cwiegert/RouterLift-v5.6-EEPROM/SD Files/SPECIAL.TXT

128 ==> €
129 ==> �
130 ==> ‚
131 ==> ƒ
132 ==> „
133 ==> …
134 ==> †
135 ==> ‡
136 ==> ˆ
137 ==> ‰
138 ==> Š
139 ==> ‹
140 ==> Œ
141 ==> �
142 ==> Ž
143 ==> �
144 ==> �
145 ==> ‘
146 ==> ’
147 ==> “
148 ==> ”
149 ==> •
150 ==> –
151 ==> —
152 ==> ˜
153 ==> ™
154 ==> š
155 ==> ›
156 ==> œ
157 ==> �
158 ==> ž
159 ==> Ÿ
160 ==>  
161 ==> ¡
162 ==> ¢
163 ==> £
164 ==> ¤
165 ==> ¥
166 ==> ¦
167 ==> §
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
