cwiegert/RouterLift-v5.6-EEPROM/Wiegert_Lift_v560_09_20_2021/Wiegert_Lift_v560_09_20_2021.ino

            // Library for the HMI, Nextion 7" touch screen display     
#include <AccelStepper.h>       // Library for Stepper Controller.   Used to talk to the stepper motor
#include "SdFat.h"
#include <EEPROM.h>
#include "RouterLiftGlobVars.h"
#include "RouterLiftNextionObjects.h"


 /*************************************************************************************************************************************
  Wiegert Router Lift

  v.4.4.1_03_15_2020
  3_15_2020
  Cory D. Wiegert

  This is a router lift controller where an arduino mega is wired through a tb6600 connected to a nema23 stepper motor
  using a Nextion 7" intelligent HMI
  
  01/23/2020 -- CDW   important to note, the GetVal functions for all the Nextion objects will only work if utilizing
                      the new base class libraries  NexConfig.h, NexHardware.cpp and NexHardware.h downloaded from
                      https://forum.arduino.cc/index.php?topic=620821.0
                      
                      Through testing - any value over 18000 (at 8 mirosteps) starts overdriving the controller and setting the motors out of phase
                      speeds around 450-650 seem to phase switch the motors as well, and shuddering of the lead screw occurs.

  01/24/2020 -- CDW   IMPORTANT!!!!! Found out the hard way, if we remove buttons or slide things around in the Nextion IDE, make sure to check the object id's with the
                      NEX<object> definition section.   When the create/remove/move around happens in the IDE, it seems the object ID's are modified,
                      thereby causing the listening service on the arduino to mis-match the objects with the call backs.
                    
                      ALSO -- this may be a grounding problem.  If the Nextion is not grounded correctly, there are unexplainable behaviors
                      the same error is flagged when there is a grounding problem

  02/12/2020 -- CDW   change the settings screen, putting the pin and variable configuration into the UI
            v2.7
  02/15/2020 -- CDW   Very good complete version finished.   Will call this version 3.0 and will deploy for burn-in test on teh router table.
            v 3.0      put to the router table on 2/17/2020, have the file for the Memory screen set to tokenize it based on the section
  02/21/2020 -- CDW   Error dialog implemented, fixed error logging to the HMI screen
            v 3.13     Deployed to the router lift on 02/22/2020 at 12/30 PM
  02/23/2020 -- CDW   added versioning, fixed a couple small bugs, redployed to router 
          v. 3.14_02_22_2020
  02/23/2020 -- CDW   modified how the pushcallbacks worked for the up and down buttons on settings and memory
          v. 3.15_02_23_2020
  02/23/2020 -- CDW   modified how all the saves, deletes and write to disk work on Memory screen.   Will add goto 0 button
                      on the memory screen as well.   button will lower router after completing mortise cuts
  02/24/2020 -- CDW   refactored some of the inefficient code, change some fo the callbacks to point to same functions
        v. 4.1_02_24_2020
  02/24/2020 -- CDW   refactored the write to file on the Memory screen.  Now, all lines are read to structure, and rewritten
                      no more losing content, or having strange characters bleed into the file.   No change to the UI in the Nextion
                      IDE
        v 4.1.1_02_24_2020
  02/26/2020 -- CDW   Refactored memory file config.   Allowed for an old file to be opened, and not over write the data in that file
        v. 4.2.1_02_26_2020
  02/29/2020  -- CDW  Refactored errors  to read the strings from a file.  Rewrote function ErrorDialog and all ErrorDialog commands
        v 4.3.1_02_29_2020
  03_07_2020 -- CDW   fixed error on memory screen.   change the check to -currentPosition() because we are storing positions above the tabel as 
                      positive #'s
        v.4.3.2_03_07_2020
  03_08_2020 -- CDW   modified the bits screen, have all the custom bit movement configured in HEIGHTS.cfg, and can configure the bits without
                      having to recompile.   Am using the LoadRouterfromMemory function to set the router off the bits screen
        v.4.4.0_03_08_2020
  03_15_2020 -- CDW   added a position field to the Memory screen so we are notified when the router has stopped moving.   Gives us a flag
                      that we have reached the height set in the depth field.
        v.4.4.1_03_15_2020
  09_19_2020  CDW -- line 1358 moved from 1351.   The top limit switch was not working when router was moving up.   Checking the buffer after 
                      a move insted of before the move.   Up function now exactly the same as the down function
        v. 5.5.0_0_03_2021
  01_03_2021  CDW --   starting the code on the power fence.   Adding ball screw and limit switches, controlling fence with HMI
  02_20_2022  CDW --   modified the setPosition and SaveToMemory functions to account for router position instead of curPos  Needed to fix the settings
                        screen so the router position is set every time instead of getting the fence position if the fence was last button
                        pushed
        v. 5.60_09_20_2021_A
  08_22_2022  CDW --  Modified the section for looking up custom bits from EEPROM.   the bug was EEPROM.read when it should have been EEPROM.get
  10_22_2022  CDW --  Modified readSettingsEEPROM() to use EEPROM.get everywhere.   search date for documented line change
  11_20_2022  CDW --  added the bounceMotorOffLimit function to streamline code and manage the limit switches all in 1 place
  12_07_2022  CDW --  change the limit switches, had to modify loadMemorytoRouter to change the while loops.   Also move to 0 first, then move 
                      to the heights either in the memory or on the presets
  12_11_2022  CDW --  updated bUp and bDown buttons to use moveTo instead of move.
  02_12_2023  CDW --  fixed bug where the automove button was moving very very slowly.   It may have been because there was a read of the stop
                      button in the move loop.   replaced the button.betValue with a nexSerial.read(), similar to what is done on the arrow buttons
  02_22_2023  CDW --  modified the automated move function to bounceMotorOffLimit, instead of putting logic in function
  03_10_2023  CDW --  modified setup to chedk if any motor is pegged against a swtich.   If so, run the bounceMotorOffSwitch() to unpeg it
  09_20_2025  CDW --  reset the environment on the MAC, testing any code readiness to load final working code
                      modified the HMI to pull a useless button, and change background colors.  
                      

*****************************************************************************************************************************************************************************/
      
        /****************************************************************************************
           Decare the AccelStepper object and use the FULL2WIRE as a type of stepper motor.
           connecting to the TB6600, it is a 2 wire control.   

           The pins must be defined and configured here, they can not be part of the Setup - because sRouter is set as a global variable
           it must have the buttons defined, prior to the setup
         *************************************************************************/
//        SdFat   sdCard;                       //  pointer to the SD card reader.   Used in storing config and memory files
        AccelStepper  sRouter (AccelStepper::FULL2WIRE, stepPin, directionPin, HIGH);
        AccelStepper  sFence (AccelStepper:: FULL2WIRE, fenceStepPin, fenceDirPin, HIGH);
        AccelStepper  *sStepper ;
        
        // Declare your Nextion objects - Example (page id = 0, component id = 1, component name = "b0"    Fully qualifying with the screen name
        //  creates ability to use in nexSerial.write commands, without having to go through the libraries)
              
/********************************
  Single function call to turn off power to motor
*********************************/
        
        int turnMotorOff( int bON)
        {
          char  sCommand[44] = {'\0'};
          
          if (bON == UP)                  // Turn the motor controler off
          {
            digitalWrite ( enablePin, HIGH);
            digitalWrite (fenceEnablePin, HIGH);
            //btPower.setValue(UP);
           // btMemOff.setValue(UP);
           // btSetOff.setValue(UP);
            digitalWrite (stepPin, LOW);
            digitalWrite (fenceStepPin, LOW);
            bON =  UP;
          }
          else                           // Turn the motor controller on
          {
            digitalWrite ( enablePin, LOW);
            digitalWrite (fenceEnablePin, LOW);
            //btPower.setValue(DOWN);
            //btMemOff.setValue(DOWN);
            //btSetOff.setValue(DOWN);
            digitalWrite (stepPin, HIGH);
            digitalWrite (fenceStepPin, HIGH);
            bON = DOWN;
          }
          return bON;
        }
        
/******************************************************
  void  getSettingsScreen(char *verString)
      Function to load all the settings from the pins and files.   be very careful with this section
      
01/09/2021 ---->   need to put the settings from the fence ball screw in here.....

09/20/2021 --->   Want to modify this code to use the EEPROM instead of the SD card.   by using EEPROM, the SD shield can be 
                  eliminated, and the top/bottom limits and 0 setting can be stored to EEPROM to reset on startup.
      
********************************************************/
        void   getSettingsScreen( char *verString)
        {
          char    tempWriter[60] = {'\0'};
          float   limTemp;
          int     i = 0;
        
          memset(tempWriter, '\0', sizeof(tempWriter));
          sprintf_P(tempWriter, PSTR("Settings.tUpVal.txt=\"%d\""), TOP_SWITCH);
          nexSerial.write(tempWriter);
          FlushBuffer();
          sprintf_P(tempWriter, PSTR("Settings.tDownVal.txt=\"%d\""), BOTTOM_SWITCH);
          nexSerial.write(tempWriter);
          FlushBuffer();
          sprintf_P(tempWriter, PSTR("Settings.tZeroPin.txt=\"%d\""), REZERO);
          nexSerial.write(tempWriter);
          FlushBuffer();
          sprintf_P(tempWriter, PSTR("Settings.tStepPin.txt=\"%d\""), stepPin);
          nexSerial.write(tempWriter);
          FlushBuffer();
          sprintf_P(tempWriter, PSTR("Settings.tSDPin.txt=\"%d\""), SD_WRITE);
          nexSerial.write(tempWriter);
          FlushBuffer();
          sprintf_P(tempWriter, PSTR("Settings.tEnablePin.txt=\"%d\""), enablePin);
          nexSerial.write(tempWriter);
          FlushBuffer();
          sprintf_P(tempWriter, PSTR("Settings.tDirectionPin.txt=\"%d\""), directionPin);
          nexSerial.write(tempWriter);
          FlushBuffer();
          sprintf_P(tempWriter, PSTR("Settings.tMaxSpeed.txt=\"%ld\""), maxMotorSpeed);
          nexSerial.write(tempWriter);
          FlushBuffer();
          sprintf_P(tempWriter, PSTR("Settings.tWorkSpeed.txt=\"%ld\""), workingMotorSpeed);
          nexSerial.write(tempWriter);
          FlushBuffer();
          sprintf_P(tempWriter, PSTR("Settings.tStepSize.txt=\"%d\""), stepSize);
          nexSerial.write(tempWriter);
          FlushBuffer();
          sprintf_P(tempWriter, PSTR("Settings.tFStep.txt=\"%d\""), fenceStepPin);
          nexSerial.write(tempWriter);
          FlushBuffer();
          sprintf_P(tempWriter, PSTR("Settings.tFEnable.txt=\"%d\""), fenceEnablePin);
          nexSerial.write(tempWriter);
          FlushBuffer();
          sprintf_P(tempWriter, PSTR("Settings.tFDir.txt=\"%d\""), fenceDirPin);
          nexSerial.write(tempWriter);
          FlushBuffer();
          sprintf_P(tempWriter, PSTR("Settings.tBackSW.txt=\"%d\""), BACK_SWITCH);
          nexSerial.write(tempWriter);
          FlushBuffer();
          sprintf_P(tempWriter, PSTR("Settings.tFSW.txt=\"%d\""), FRONT_SWITCH);
          nexSerial.write(tempWriter);
          FlushBuffer();
          sprintf_P(tempWriter, PSTR("Settings.tFZero.txt=\"%d\""), FENCE_ZERO);
          nexSerial.write(tempWriter);
          FlushBuffer();

          sprintf_P(tempWriter, PSTR("Settings.tFileName.txt=\"%s\""), storeFile);
          nexSerial.write(tempWriter);
          FlushBuffer();
          memset (tempWriter, '\0', sizeof(tempWriter));
          tLowLimit.getText(tempWriter, sizeof(tempWriter));
          if (strlen(tempWriter) > 0)
          {
            limTemp = atof(tempWriter) / (distPerStep * 4);
            lowLimit = -limTemp;
          }
          memset (tempWriter, '\0', sizeof(tempWriter));
          tUpLimit.getText(tempWriter, sizeof(tempWriter));
          if (strlen(tempWriter) > 0)
        
          {
            limTemp = atof(tempWriter) / (distPerStep * 4);
            highLimit = -limTemp;
          }
            tVersion.setText (verString);
            FlushBuffer();
        }
      
/*********************************
     int   ErrorDialog (char *outMessage, char *b1Text, char *b2Text, char *yesScreen , char *noScreen)
              this will pop up the error screen, set the message txt in multiline format, set the buttons
              to the text passed in, and if appropriate, navigate to a new place in the app
              The yesScreen and noScreen will navigate to the designated screen when the error dialog is closed.
              b1Text and b2Text will be displayed on the Yes and No buttons
 ***********************************************************************************************/
        
        int   ErrorDialog (int ErrorNum) {
         
          char  msgCommand[300] = {'\0'};
          char  errorString[200] = {'\0'};        // used for the fgets function to read a file line
          char  bYesLbl[24] = {'\0'};
          char  bNoLbl[24] = {'\0'};
          int   serRead[7];
          char  errorTitle[25] = {'\0'};
          char  errorText[200] = {'\0'};
          char  yesScreen[12] = {'\0'};
          char  noScreen[12] = {'\0'};
          char  *token, *elim;
          char  delim[] = {',','\0'};
          char  crCheck[2] = {'^', '\0'};
          char  checker;
          char  errText1[200];
          char  errText2[200];
          char  errText3[200];
          char  errText4[200];
          char  errText5[200];
          int   i, p;
          SdBaseFile   fError;
          if(!fError.open("Error.cfg"))
            {
              return 0;
            }
          fError.rewind();
          checker = '1';
          while (checker != '^')              // read the header
            {
           
              checker = fError.read();
            }

          checker = fError.fgets(errorTitle, sizeof(errorTitle));         //read the carraige return before the errors start
          while ( fError.available())
            {
              memset (errorString, '\0', sizeof(errorString));
              fError.fgets (errorString, sizeof(errorString));
              token =strtok(errorString, delim);

              if (atoi(token) == ErrorNum)
                {
                  for (i=2; i<= 7; i++)
                    {
                      token = strtok(NULL, delim);
                      switch (i)
                        {
                          case 2:
                            strcpy(errorTitle, token);
                            break;
                          case 3:
                            strcpy(errorText, token);
                            break;
                          case 4:
                            strcpy(bYesLbl, token);
                            break;
                          case 5:
                            strcpy(bNoLbl, token);
                            break;
                          case 6:
                            strcpy(yesScreen, token);
                            break;
                          case 7:
                            strcpy(noScreen, token);
                            fError.seekEnd();
                            break;
                        }
                    }
                }
            }
          fError.close();
          nexSerial.write("page Error");
          FlushBuffer();   
          if (strlen(bYesLbl) > 0)
          {
            sprintf_P(msgCommand, PSTR("Error.bYes.txt=\"%s\""), bYesLbl);
            nexSerial.write(msgCommand);
            FlushBuffer();
          }
        
          if (strlen(bNoLbl) > 0)
          {
            sprintf_P(msgCommand, PSTR("Error.bNo.txt=\"%s\""), bNoLbl);
        
            nexSerial.write(msgCommand);
            FlushBuffer();
          }      
         
          sprintf_P(msgCommand, PSTR("Error.tErrorHead.txt=\"%s\""), errorTitle);
          nexSerial.write(msgCommand);
          FlushBuffer();
          memset (msgCommand, '\0', sizeof(msgCommand));
          token = strtok(errorText, crCheck);
          p=0;
          for (i = 0; i<=4; i++)
            {
              if ( token !=NULL)
                {
                  switch (i)
                    {
                      case 0:
                        sprintf_P(errText1, PSTR("%s"),token);
                        break;
                      case 1:
                        strcpy (errText2, token);
                        p++;
                        break;
                      case 2:
                        strcpy (errText3, token);
                        p++;
                        break;
                      case 3:
                        strcpy (errText4, token);
                        p++;
                        break;
                      case 4:
                        strcpy (errText5, token);
                        p++;
                        break;
                    }
                 token = strtok(NULL, crCheck);
                }
              else
                 i=6;
            }
          switch (p)
            {
              case 0:
                sprintf_P(msgCommand, PSTR("Error.tErrorMsg.txt=\"%s\""), errorText);
                break;
              case 1:
                sprintf_P(msgCommand, PSTR("Error.tErrorMsg.txt=\"%s\r\n%s\""), errText1, errText2);
                break;
              case 2:
                sprintf_P(msgCommand, PSTR("Error.tErrorMsg.txt=\"%s\r\n%s\r\n%s\""), errText1, errText2, errText3);
                break;
              case 3:
                sprintf_P(msgCommand, PSTR("Error.tErrorMsg.txt=\"%s\r\n%s\r\n%s\r\n\%s\""), errText1, errText2, errText3, errText4);
                break;
              case 4:
                sprintf_P(msgCommand, PSTR("Error.tErrorMsg.txt=\"%s\r\n%s\r\n%s\r\n\%s\r\n%s\""), errText1, errText2, errText3, errText4, errText5);
                break;
              
            } 
    //      sprintf_P(msgCommand, PSTR("Error.tErrorMsg.txt=\"%s\""), errorText);
          nexSerial.write(msgCommand);
          FlushBuffer();
 
          if (nexSerial.peek() != 101)
            nexSerial.read();
          while (nexSerial.peek() != 101 )
          {
            nexSerial.read();
            delay(100);
          }
          memset(serRead, '\0', sizeof(serRead));
          for (int i = 0; i <= 6; i++)
            serRead[i] = nexSerial.read();
          memset (msgCommand, '\0', sizeof(msgCommand));
          if (serRead[2] == 4)
            sprintf_P(msgCommand, PSTR("page %s"), yesScreen);
          else if (serRead[2] == 5)
            sprintf_P(msgCommand, PSTR("page %s"), noScreen);
          nexSerial.write (msgCommand);
          FlushBuffer();
          return serRead[2];
        
        }


/****************************************************
  int stepsFromDistance( int move_go, int index)

     Returns the  index of the structure that matches with the value from the drop down
     This is typically used after the drop down selection for travel distance
     it will check the move/goto button to figure out if we are moving a set distance
     or setting the height from a fixed position.  If a fixed position, the 0 value of that
     position should be the "table" height
*********************************************/
        
        int stepsFromDistance(int move_go, int index) {
         
          int  counter;
          bool  bContinue =1;
          if(move_go)
            {
              EEPROM.get (4090, eeAddress);   // CDW   modifield 08_22_2022, changed from EEPROM.read to EEPROM.get
              counter = 0;              // called from the automove, looking at heights, 0 based array
            }
          else
            {
              EEPROM.get (4092, eeAddress);    // CDW   modifield 08_22_2022, changed from EEPROM.read to EEPROM.get
              counter = 1;              // called from custom bits screen, looking at custom bits section, 1 based array
            }
      
          do
            {             
               EEPROM.get(eeAddress, preSetLookup);  
               eeAddress += sizeof(preSetLookup);
               counter += 1;
            } while ( bContinue && counter < index + 1);
                        
          return preSetLookup.steps;
        }
/****************************************************        
 *     long   calcSteps (float   inchValue)
 *         returns the number of steps to travel, given the value of inches passed to the function
 ***************************************************/
        long   calcSteps (float inchValue) {
            return inchValue / distPerStep * 4;  // 4 microsteps per step
          
        }

/*************************************************
   void   setPositionField()
            sets the tPosoition field on the home screen.   called after a router move
            03_15_2020 -- added the position field on the Memory screen
   01/03/2021 --- need a fence position field, need to set the position.   Need a variable in the function call to know which position field to change
 *************************************************/
        void setPositionField(bool bMotor) {
          char buffer[16];
          char  sCommand[40];
        
          
          if (bMotor == 1)
            curPosInch = sRouter.currentPosition() * distPerStep / 4;
          else
            curPosInch = sFence.currentPosition() * distPerStep / 4;
          if (curPosInch != 0) 
            {
              memset (buffer, '\0', sizeof(buffer));
              dtostrf(-curPosInch, 3, 4, buffer); 
              dtostrf(-curPosInch, 3, 4, posInch);
            //v. 5.60_09_20_2021_A
              dtostrf(-curPosInch, 3, 4, curRoutPosInch);
            }
          else
            strcpy(buffer, "0.00");
         if (bMotor == 1)
            {
              sprintf_P(sCommand, PSTR("Home.tPosition.txt=\"%s\""), buffer);
              nexSerial.write(sCommand);
              FlushBuffer();
              sprintf_P(sCommand, PSTR("Settings.tSetPosit.txt=\"%s\""), buffer);
              nexSerial.write(sCommand);
              FlushBuffer();
              sprintf_P(sCommand, PSTR("Bits.tBitsPos.txt=\"%s\""), buffer);
              nexSerial.write(sCommand);
              FlushBuffer();
              sprintf_P(sCommand, PSTR("Memory.tMemPosit.txt=\"%s\""), buffer);
              nexSerial.write(sCommand);
              FlushBuffer();
            }
          else
            {
            
              sprintf_P(sCommand, PSTR("Settings.tFencePos.txt=\"%s\""), buffer);
              nexSerial.write(sCommand);
              FlushBuffer();
              sprintf_P(sCommand, PSTR("Memory.tFencePos.txt=\"%s\""), buffer);
              nexSerial.write(sCommand);
              FlushBuffer();
              sprintf_P(sCommand, PSTR("Bits.tFencePos.txt=\"%s\""), buffer);
              nexSerial.write(sCommand);
              FlushBuffer();
              sprintf_P(sCommand, PSTR("Home.tFencePos.txt=\"%s\""), buffer);
              nexSerial.write(sCommand);
              FlushBuffer();
              
            }      
        }
             
/****************************************************************************
 *      void  readSettingsEEPROM()
 *          reads all the pins and motor settings from EEPROM
 *          use EEPROM_WRITER_ROUTER.ino to put all the settings into EEPROM
 *          this will pull them back, and store into the global variables
 * **************************************************************************/
    void readSettingsEEPROM()
      {
          eeAddress = 0;
          EEPROM.get (eeAddress, directionPin);
          eeAddress += sizeof(directionPin);
          EEPROM.get(eeAddress, fenceDirPin);
          eeAddress += sizeof(fenceDirPin);
          EEPROM.get(eeAddress, stepPin);
          eeAddress += sizeof(stepPin);
          EEPROM.get(eeAddress, fenceStepPin);
          eeAddress += sizeof(fenceStepPin);
          EEPROM.get(eeAddress, enablePin);
          eeAddress += sizeof(enablePin);
          EEPROM.get(eeAddress, fenceEnablePin);
          eeAddress += sizeof(fenceEnablePin);
          EEPROM.get(eeAddress, initSpeed);
          eeAddress += sizeof(initSpeed);
          EEPROM.get(eeAddress, stepsPerRevolution);
          eeAddress += sizeof(stepsPerRevolution);
          EEPROM.get(eeAddress, microPerStep);
          eeAddress += sizeof(microPerStep);  
          EEPROM.get(eeAddress, pulseWidthMicros);
          eeAddress += sizeof(pulseWidthMicros);
          EEPROM.get(eeAddress, millisBetweenSteps);
          eeAddress += sizeof (millisBetweenSteps);
          EEPROM.get(eeAddress, TOP_SWITCH);
          eeAddress += sizeof (TOP_SWITCH);
          EEPROM.get(eeAddress, BOTTOM_SWITCH);
          eeAddress += sizeof (BOTTOM_SWITCH);
          EEPROM.get(eeAddress, FRONT_SWITCH);
          eeAddress += sizeof (FRONT_SWITCH);
          EEPROM.get(eeAddress, BACK_SWITCH);
          eeAddress += sizeof (BACK_SWITCH);
          EEPROM.get (eeAddress, REZERO);       //  10_16_2022 CDW --> changed to EEPROM.get to match 
          eeAddress += sizeof(REZERO);
          EEPROM.get(eeAddress, maxAcceleration);
          eeAddress += sizeof(maxAcceleration);
          EEPROM.get (eeAddress, distPerStep);
          eeAddress += sizeof(distPerStep);   
          EEPROM.get(eeAddress, maxMotorSpeed);
          eeAddress += sizeof(maxMotorSpeed);
          EEPROM.get(eeAddress, workingMotorSpeed);
          eeAddress += sizeof(workingMotorSpeed);
          EEPROM.get(eeAddress, ver);
          eeAddress+= sizeof(ver);
  
         if (DEBUG)
           {
              debugLn(F("\r\n========\r\n"));
              debug (F("directionPin ==> "));
              debugLn(byte(directionPin));
              debug (F("fenceDirPin ==> "));
              debugLn(fenceDirPin);
              debug(F("stepPin ==> "));
              debugLn(stepPin);
              debug (F("fenceStepPin ==> "));
              debugLn(fenceStepPin);
              debug (F("enablePin ==> "));
              debugLn(enablePin);
              debug(F("initSpeed ==> "));
              debugLn (initSpeed);       
              debug(F("stepsPerRevolution ==> "));
              debugLn(stepsPerRevolution);
              debug(F("microPerStep ==> "));
              debugLn(microPerStep);       
              debug(F("pulseWidthMicros ==> "));
              debugLn(pulseWidthMicros);
              debug (F("millisBetweenSteps ==> "));
              debugLn(millisBetweenSteps);
              debug (F("TOP_SWITCH ==> "));
              debugLn(TOP_SWITCH);
              debug(F("BOTTOM_SWITCH ==> "));
              debugLn(BOTTOM_SWITCH);
              debug(F("FRONT_SWITCH ==>"));
              debugLn (FRONT_SWITCH);
              debug (F("BACK_SWITCH ==> "));
              debugLn(BACK_SWITCH);
              debug(F("REZERO ==> "));
              debugLn(REZERO);
              debug (F("maxAcceleartion ==> "));
              debugLn(maxAcceleration);
              debug(F("distPerStep ==> "));
              debug(F("maxMotorSpeed == > "));
              debugLn(maxMotorSpeed);
              debug(F("workingMotorSpeed ==> "));
              debugLn(workingMotorSpeed);
              debug(F("version ==> "));
              debugLn(ver);
           }  
      }

/****************************************************************
  void SetSpeedFromSlider (float iSpeed, byte button)

     setSpeedFromSlider will set the  new motor speed in steps per second
     and update the UI wth the new spead values
 *********************************************************/
        
        void setSpeedFromSlider (float iSpeed, byte button) {
          long perCalc;
          char   serCommand[55] = {'\0'};
           if (button == HIGH)
          {
            perCalc = (iSpeed / maxMotorSpeed) * maxMotorSpeed;
          }
          else
          {
            perCalc = (iSpeed / 100) * maxMotorSpeed;
          }
          hMoveSpeed.setValue(perCalc);
          nSetSpeed.setValue(perCalc);
          sprintf_P(serCommand, PSTR("Settings.tWorkSpeed.txt=\"%ld\""), perCalc);
        
          nexSerial.write(serCommand);
          FlushBuffer();
          workingMotorSpeed = perCalc;
        
        }
        
/*************************************************
    void  deleteFromMemory( int memrow)
            Deletes a row from the memory screen
 ******************************/
        void deleteFromMemory (int memrow) {
        
          char zero[21] = {'\0'};
          char steps[20] = {'\0'};
          char label[27] = {'\0'};
        
          snprintf (zero, 14, "tZero%d.txt=\"\"", memrow);
          snprintf(steps, 18, "tMem%dSteps.txt=\"\"", memrow);
          snprintf(label, 26, "tMem%d.txt=\"\"", memrow);
          nexSerial.print(zero);
          FlushBuffer();
          nexSerial.print(steps);
          FlushBuffer();
          nexSerial.print(label);
          FlushBuffer();
        }
        
/*************************************************
    void  saveToMemory( int memrow, double posInch, char curPos)
            adds the current position of the router to 1 of the saved memory spots on Memory Page
 ******************************/
        void saveToMemory (int memrow) {
        
          char zero[30] = {'\0'};
          char steps[30] = {'\0'};
        
        //v. 5.60_09_20_2021_A
          snprintf(zero, 22, "tZero%d.txt=\"%s\"", memrow, posInch);
          snprintf(steps, 24, "tMem%dSteps.txt=\"%ld\"", memrow, sRouter.currentPosition());
          nexSerial.print(zero);
          FlushBuffer();
          nexSerial.print(steps);
          FlushBuffer();
        }
        
/*************************************************
   void  loadMemorytoRouter( int memrow)
           loads the values from memory and sets the router to that position.
******************************/
        void loadMemorytoRouter ( NexText &button, int bHow) {
          char buffer[31];
          float inches;
          long stepsToMove = 0;
          int  buttonNum;
          byte direct;
          uint16_t  characters;

          memset (buffer, '\0', sizeof(buffer));
          characters = button.getText(buffer, sizeof(buffer));
          inches = atof(buffer); 
          stepsToMove = calcSteps (inches); 

/* debugLn("about to call ErrorDialog(200)");
         ErrorDialog(200);
         if (lowLimit == 0)
            buttonNum = ErrorDialog( 200 );  */
         bgotoZeroPopCallback(&bBitsZero);       // 12_7_2022  modified, and move to 0 first, then up to the preset
         sRouter.moveTo(stepsToMove);
         sRouter.setSpeed(-workingMotorSpeed);
         direct = UP;
         bGo = 1;

         while (sRouter.currentPosition() != -sRouter.targetPosition() && bGo && !digitalRead(TOP_SWITCH) && !digitalRead(BOTTOM_SWITCH))  // modified this, as the opposite of the standard values.   Saving above table as + numbers
            {          
              sRouter.runSpeed();


              if (bGo)
                bGo = checkStopButton();
            }
          if (digitalRead(TOP_SWITCH)  || digitalRead(BOTTOM_SWITCH))     // hit a limit switch in the previous loop
            {
              nexSerial.print("vis pStop,1");              // bring up the Stop sign to help remind we have hit a limit switch
              FlushBuffer();
              
              if (digitalRead(TOP_SWITCH))      // 02_22_2023 changed the logic here to call bounceMotorOffLimit
                {
                  bounceMotorOffLimit (TOP_SWITCH, DOWN, &sRouter);
                  //sRouter.moveTo( sRouter.currentPosition() + 600); 
                  //sRouter.setSpeed (workingMotorSpeed);
                }
              else
                {
                  bounceMotorOffLimit (BOTTOM_SWITCH, UP, &sRouter);
                  
                  //sRouter.moveTo(sRouter.currentPosition() - 600); 
                  //sRouter.setSpeed(-workingMotorSpeed);
                }
              //while (sRouter.currentPosition() != sRouter.targetPosition())       // 02_22_2023  commented out because of bounceMotorOffLimit
              //  sRouter.runSpeed();
              bGo = UP;
            }
          nexSerial.print("vis pStop,0");              // bring up the Stop sign to help remind we have hit a limit switch
          FlushBuffer();
          setPositionField(1);    
        }
        
/********************************************************************
 *    void bCustBitPushCallback (void *ptr)
 *        used on the Bits screen to lift the bit to the right height 
 *        likely will call either LoadMemorytoRouter or bAutoCallBack (from the presets)
 *        Needs to calculate steps from thickness (1/2 thickness entered + bit center)
 ************************************************************************/
    void bCustBitPushCallback (void *ptr){
            
      char  thickness[16];
      int   fraction;
      float  inches;
      uint32_t   decimal;
      char   sCommand[80];
      char  newThick[16];
      char   buffer[31];

      memset (thickness, '\0', sizeof(thickness));
      tThickEntry.getText(thickness, sizeof(thickness));
      sw0.getValue(&decimal);
      fraction = decimal;

     if (fraction == 0)      
        {
          inches = (atof(thickness)/2) + preSetLookup.decimal;
          dtostrf(inches, 3, 4, newThick);
          sprintf_P(sCommand, PSTR("t3.txt=\"%s\""),newThick);
          nexSerial.write(sCommand);
          FlushBuffer();
          memset (buffer, '\0', sizeof(buffer));
          fraction =t3.getText(buffer, sizeof(buffer));
        } 
      loadMemorytoRouter (t3, LOW); 
      memset (buffer, '\0', sizeof(buffer));
      sprintf_P(sCommand, PSTR("t1.txt=\"%s\""), preSetLookup.label);
      nexSerial.write(sCommand);
      FlushBuffer();
          
    }
      
/*************************************************
    void  memToFileSD(  NexText &Desc, NexText &Value, NexText &Steps)
            writes index, description, inch value and number of steps to the SD card
 ******************************/
        void memToFileSD ( int index, NexText &Desc, NexText &Value, NexText &Steps, char divider, char section) {
         //void memToFileSD ( int index, char *Desc, char *Value, char *Steps, char divider, char section) {
        
          struct preSets  {
            int     counter;
            char    Name[26];
            char   inches[12];
            char  steps[12];
          }  writeString[8];
        
          char  Name[40] = {'\0'};
          char  writeS[40] = {'\0'};
          char  *token;
          char  checker;
          byte  bFound = 0;
          byte  bGo = DOWN;
          unsigned long   fPos;
          int   element;
 
          for (int counter = 1; counter <= 7; counter++)
            {
              element = 1;
              if (counter != index)   //   looking for the right line to replace in the config
                {
                   EEPROM.get(eeAddress, writeString[counter]);
                   eeAddress += sizeof(writeString);
                   counter++;
                }
               else                   //   Found the line to replace with the new line from the screen
                {
                   writeString[counter].counter = index;
                   Desc.getText(writeString[counter].Name, sizeof(writeString[counter].Name));
                   Value.getText(writeString[counter].inches, sizeof(writeString[counter].inches));
                   Steps.getText(writeString[counter].steps, sizeof(writeString[counter].steps));
                }
            }
          for (int counter=1; counter <=7; counter++)   // rewrite the memory - when writing EEPROM, sprintf
            {
               EEPROM.put(eeAddress, writeString[counter]);
               eeAddress += sizeof(writeString) ;      
            }

        }
/*****************************************************
   int  LoadFromFile ( int StartRow, int NumRows)
          Loads data from config file for the start position up to te number of rows.
          Loads the Memory screen for the rows of specific bookmarked presets
          input:
                  StartRow == which index row to start reading
                  MaxRow == which row to stop reading
                  fileName == which file to use for reading
                  PageNum == which section in the file (going to be used to store different type of settings)
          puts the data into the data fields on the screen
 *****************************************************/
        
        int  LoadFromFile ( int StartRow, int MaxRow, int tokenKey, int Section)  
          {
        
          SdBaseFile    fReader;
          int           element;
          int           counter;
          int           index;
          char          delimeter[2] = {char(tokenKey), '\0'};
          char          *token;
          char          checker;
          uint32_t      filePos;
          char          divider = '^';
        
          struct preSets  {
            char    delimeter[2];
            int     counter;
            char    Name[27];
            char   inches[12];
            char  steps[12];
          }  memory[8];
        
          char        Name[38] = {'\0'};
          char        inches[22] = {'\0'};
          char        steps[25] = {'\0'};
          char        writeS[75] = {'\0'};
        
          if ( !fReader.open(storeFile))
            ErrorDialog (206);   
          index = StartRow;
          fReader.rewind();
          while (writeS[3] != '0' + index && fReader.available()) // read through the header and excluded lines
            fReader.fgets(writeS, sizeof(writeS));
          while (index >= StartRow && index <= MaxRow && fReader.available())
          {
            if (index != StartRow)
            {
              memset (writeS, '\0', sizeof(writeS));
              fReader.fgets(writeS, sizeof(writeS));
            }
            if (writeS[3] != '\0')
              {
                token = strtok(writeS, delimeter);            // tokenize the line and split out the appropriate fields from the string
             
//                strcpy(memory[index].delimeter, char(token)); 
                element = 1;
                while (token != NULL)
                {
                  token = strtok(NULL, delimeter);
                  switch (element)
                  {
                    case 0:
                      element++;
                      break;
                    case 1:
                      memory[index].counter = atoi(token);
                      element++;
                      break;
                    case 2:
                      sprintf_P(memory[index].Name, PSTR("%s"), token);
                      if (memory[index].Name[0] == '\n')
                        memory[index].Name[0] = '\0';
                      element++;
                      break;
                    case 3:
                      sprintf_P(memory[index].inches, PSTR("%s"), token);
                      element++;
                      break;
                    case 4:
                      sprintf_P(memory[index].steps, PSTR("%s"), token);
                      element++;
                      break;
                    case 5:
                      break;
                  }
                }
                index++;
              }
          }
          MaxRow = index;
          for ( index = StartRow; index <= MaxRow; index++)                     //  write the lines to the UI, as many as were round in the file
          {
            snprintf(Name, 37, "tMem%d.txt=\"%s\"", index, memory[index].Name);
            snprintf(inches, 21, "tZero%d.txt=\"%s\"", index, memory[index].inches);
            snprintf(steps, 24, "tMem%dSteps.txt=\"%s\"", index, memory[index].steps);
            nexSerial.write(Name);
            FlushBuffer();
            nexSerial.write(inches);
            FlushBuffer();
            nexSerial.write(steps);
            FlushBuffer();
          }
          fReader.close();
        }
        
/***************************************************
     int   checkStopButton ()
             checks to see if the Off button has been pressed during an automated move of the lift.
             usefull in chagnge bit, move router to limit or Auto button functions
 **********************************************************************/
        byte  checkStopButton ()
        {     
          int incomingByte;
          int   StopButtons[3][2] = {
            {0, 33}, {1, 14}, {2, 56}     //   these are the pages/control #'s for the stop buttons.  if the GUI changes, check here
          };
          int  screen;
          int  button;
        
          bGo = DOWN;
          incomingByte = nexSerial.read();

          while (incomingByte > -1 )
            {
              if (incomingByte == 101)
                {
                  screen = nexSerial.read();
                  button = nexSerial.read();
  
                }
              if ((StopButtons[0][0]== screen && StopButtons[0][1] == button) ||
                  (StopButtons[1][0] == screen && StopButtons[1][1] == button) || 
                  (StopButtons[2][0] == screen && StopButtons[2][1] == button) )
                {
                  bGo = UP;
                  turnMotorOff(UP);
                  return bGo;  
                }
              incomingByte = nexSerial.read();
            }
          return bGo;
        }
        
/*******************************************************
   int moveRouterToLimit(byte bDirection)

       Move to LIMIT is for moving the router until it hits a limit switch
       called by Change Bit  and the ToBottom
          01/24/2020   CDW -- Need to add the bounce function to the limit switch being triggered.    LIkely I will have a "bounce" function so I can call it from all
                              buttons that are free moving.   Whenever a limit switch is hit, we should set the speed to something slow, and bounce back until we enable the
                              limit switch again.   Using a "while LIMITSWITCH==0... move in the opposite direction....."
                              UP/DOWN is motor direction based on lead screw being inverted... UP is dow and DOWN is up
          01/31/2020   CDW -- change the function declaration to return a DOUBLE, it was an int.   Check where function is called to make sure the return is into a DOUBLE
          02/09/2020   CDW -- added the check of the OFF button being pushed.   Will use this functionality to read the reial buffer
                              if the off button is pushed, the motor shoudl stop moving.
  01/03/20201 --- need to rewrite logic to know which motor is moving.   bDirection could be up or down, front or back.   If front to back, need to use sFence instead of sRouter
  11/20/2022  CDW -- modified the bouncing off the limit switches
 * ****************************************/
        
    double moveRouterToLimit (int bDirection, double dSpeedFlag)
        {
          int whichSwitch;
          bGo = DOWN;
          if (bDirection == DOWN)
            whichSwitch = TOP_SWITCH;
          else
            whichSwitch = BOTTOM_SWITCH;
          while (!digitalRead(whichSwitch) && bGo)
          {
            if (bDirection == DOWN)
              {
                curPos = sRouter.currentPosition() - stepSize;
                sRouter.moveTo(curPos);
                if ( dSpeedFlag == -1 )
                  sRouter.setSpeed(-workingMotorSpeed);
                else
                  sRouter.setSpeed (-dSpeedFlag);
              }
            else
              {
                curPos = sRouter.currentPosition() + stepSize;
                sRouter.moveTo(curPos);
                if (dSpeedFlag == -1)
                  sRouter.setSpeed(workingMotorSpeed);
                else
                  sRouter.setSpeed (dSpeedFlag);
              }
              while (sRouter.currentPosition() != sRouter.targetPosition() && !digitalRead(whichSwitch))
                sRouter.runSpeed();
              bGo = checkStopButton();
             // btPower.getValue (&bGo);
              
          }
                  
         if (digitalRead (whichSwitch))
           {
              nexSerial.print("vis pStop,1");              // bring up the Stop sign to help remind we have hit a limit switch
              FlushBuffer();
              bounceMotorOffLimit (whichSwitch, bDirection, &sRouter ); // 11_20_2022 - removed all logic for bouncing.   Call function instead
           }
          nexSerial.print("vis pStop,0");              // bring up the Stop sign to help remind we have hit a limit switch
          FlushBuffer();
          return sRouter.currentPosition();
        }
        
/***********************************************
   void bMoveUpPushCallback(void *ptr)

         Button bMoveUP component push callback function.
         While the button is pressed, the router should move UP and interupt if the limit button is hit
   01/03/2021 --- copy this function for the Fence move back button
******************************************/
      
  void bMoveUpPushCallback(void *ptr) {
          int cBuff = -1;
      
          while (!digitalRead(TOP_SWITCH) && bGo && cBuff == -1)
            {     
              curPos = sRouter.currentPosition() - stepSize;
              sRouter.moveTo(curPos);
              sRouter.setSpeed(-workingMotorSpeed);
              while (sRouter.currentPosition() != sRouter.targetPosition()  && workingMotorSpeed > 0 && !digitalRead (TOP_SWITCH))
                sRouter.runSpeed();             
              cBuff = nexSerial.read();
            
            }
        
          if (digitalRead (TOP_SWITCH))
            {
              nexSerial.print("vis pStop,1");              // bring up the Stop sign to help remind we have hit a limit switch
              FlushBuffer();
              bounceMotorOffLimit (TOP_SWITCH, DOWN, &sRouter ); // 11_20_2022 removed all logic and call function instea
              highLimit = -curPos;
            }
          nexSerial.print("vis pStop,0");              // bring up the Stop sign to help remind we have hit a limit switch
          FlushBuffer();
          setPositionField(1);
        
        }
        
/***************************************************
   void bMoveUpPopCallback(void *ptr)

         Button bMoveUp component pop callback function.
         When the ON button is released, the LED turns on and the state text changes.
************************************/
        void bMoveUpPopCallback(void *ptr) {
          setPositionField(1);     
        }
        
/********************************************************
    void bMoveDownPushCallback (void *ptr)

         Button bMoveUP component push callback function.
        While the button is pressed, the router should move DOWNP and interupt if the limit button is hit

 01/03/2021 -- need to copy this for the Fence move forward button, change sRouter to sFence
 *****************************************************/
        void bMoveDownPushCallback (void *ptr)  {
          int cBuff = -1;
          char buffer[16];          
    
          while (!digitalRead(BOTTOM_SWITCH) && cBuff == -1 && bGo)
          {
            curPos = sRouter.currentPosition() + stepSize;
            sRouter.moveTo(curPos);
            sRouter.setSpeed(workingMotorSpeed);
        
            while (sRouter.currentPosition() != sRouter.targetPosition()  && workingMotorSpeed > 0 && !digitalRead (BOTTOM_SWITCH))
              sRouter.runSpeed();
            cBuff = nexSerial.read();
          }
       
          if (digitalRead(BOTTOM_SWITCH))
            {
              nexSerial.print("vis pStop,1");              // bring up the Stop sign to help remind we have hit a limit switch
              FlushBuffer();
              bounceMotorOffLimit (BOTTOM_SWITCH, UP, &sRouter); // 11_20_2022 removed code, calling function instead
              lowLimit = -curPos;
            }
          
          nexSerial.print("vis pStop,0");              // bring up the Stop sign to help remind we have hit a limit switch
          FlushBuffer();
          setPositionField(1);
     }
        
/****************************************************
   void bMoveDownPopCallback(void *ptr)

        Button bMoveDown component pop callback function.
        When the button is released, turn off the motor controller
*****************************************************/
        void bMoveDownPopCallback(void *ptr) {
        
          setPositionField(1);
        }
             

/***********************************************
   void bForwardPushCallback(void *ptr)

         Button bForward component push callback function.
         While the button is pressed, the router should move UP and interupt if the limit button is hit
   01/08/2021 --- Modify this for moving fence motor, this is only a prototype
******************************************/
      
 void bForwardPushCallback(void *ptr) 
   {
      int cBuff = -1;
      sStepper = &sFence;
    
      while (digitalRead(FRONT_SWITCH) && cBuff == -1 && bGo)
      {     
        curPos = sFence.currentPosition() + stepSize;
        sFence.move(curPos);
        sFence.setSpeed(workingMotorSpeed);
        while (sFence.currentPosition() != curPos)
          sFence.runSpeed();
         cBuff = nexSerial.read();
      }
          
      if (!digitalRead (FRONT_SWITCH) )
        {
          nexSerial.print("vis pStop,1");              // bring up the Stop sign to help remind we have hit a limit switch
          FlushBuffer();
          bounceMotorOffLimit (FRONT_SWITCH, BACK, &sFence);    // 11_20_2022 -- call function instead of all bouncing logic in code
        }
      //highLimit = -curPos;
      nexSerial.print("vis pStop,0");              // bring up the Stop sign to help remind we have hit a limit switch
      FlushBuffer();
      setPositionField(0);
    }
        
/***************************************************
   void bForwardPopCallback(void *ptr)

         Button bMoveUp component pop callback function.
         When the ON button is released, the LED turns on and the state text changes.
  01/08/2021 -- make sure to set the Fence position field on this - needs to be modified
************************************/
        void bForwardPopCallback(void *ptr) {
          setPositionField(0);     
        }

/********************************************************
    void bBackPushCallback (void *ptr)

         Button bBack component push callback function.
        While the button is pressed, the fence will move away from the bit until the button is released 
        or you hit the limit switch

 *****************************************************/
  void bBackPushCallback (void *ptr)  {
          int cBuff = -1;
          char buffer[16];   

          while (digitalRead(BACK_SWITCH) && cBuff == -1 && bGo)
            {
              curPos = sFence.currentPosition() - stepSize;
              sFence.move(curPos);
              sFence.setSpeed( -workingMotorSpeed);
              while (sFence.currentPosition() != curPos  && workingMotorSpeed > 0 && digitalRead(BACK_SWITCH))
                sFence.runSpeed();
            
              cBuff = nexSerial.read();
            }
              
          if (!digitalRead (BACK_SWITCH) )
            {
              nexSerial.print("vis pStop,1");              // bring up the Stop sign to help remind we have hit a limit switch
              FlushBuffer();
              bounceMotorOffLimit (BACK_SWITCH, FORWARD, &sFence);   // 11_20_2022 -- call function instead of all bouncing logic in code
            }
          nexSerial.print("vis pStop,0");              // bring up the Stop sign to help remind we have hit a limit switch
          FlushBuffer();
          setPositionField(0);
        }
        
/****************************************************
   void bBackPopCallback(void *ptr)

        Button bBack component pop callback function.
        When the button is released, set the fence position field
*****************************************************/
        void bBackPopCallback(void *ptr) {
          setPositionField(0);
        }

/************************************************************
   void swHowPopCallback(void *ptr)

         Nothing implemented on this slider button yet
*************************************************************/
        void swHowPopCallback(void *ptr) {      
        }
                
/**************************************************
 * void  swFencePopCallback(void *ptr)
 *      switch swFence on the home screen, will set the HOM_MOTOR byte to know which motor is to be
 *      used by a number of buttons on the home screen   Implmeneted in v. 5.50
 **************************************************/
  void  swFencePopCallback(void *ptr)
    {
        uint32_t   uMotor;
 
        swFence.getValue(&uMotor);
        HOME_MOTOR = uMotor;
    }


/**************************************************
 * void  swWhichPopCallback(void *ptr)
 *      switch swFence on the home screen, will set the HOM_MOTOR byte to know which motor is to be
 *      used by a number of buttons on the home screen   Implmeneted in v. 5.50
 **************************************************/
  void  swWhichPopCallback(void *ptr)
    {
        uint32_t   uMotor;
 
        swWhich.getValue(&uMotor);
        SET_MOTOR = uMotor;
    }

/***********************************************

   void bReZeroPopCallback(void *ptr)

         Button bReZero component push callback function.
         When the button is released, we will want to set a new ZERO reference for the lift.

**************************/
        
        void bReZeroPopCallback(void *ptr) {
        
          if (HOME_MOTOR == 1)
            {
              sRouter.setCurrentPosition(0);
              setPositionField(1);
            }
          else
            {
              sFence.setCurrentPosition (0);
              setPositionField(0);
            }
          
        }
        
/***********************************************
   void bZeroPopCallback(void *ptr)

         Button bZero component push callback function.
         When the button is released, we will want to set a new ZERO reference for the lift.
         Make sure setspeed() is called after move()

 01/13/2021 -- tookk out while loop with run() function, changed to runSpeedToPosition() for router life section.   
**************************/
        
        void bZeroPopCallback(void *ptr) {
        
          char   buffer[20];
          uint32_t   uDirection;
          byte       bDir;
        
          if (SET_MOTOR == 1 )
            {
              sRouter.setCurrentPosition (0);
              while (digitalRead(REZERO) && !digitalRead(TOP_SWITCH) && !digitalRead(BOTTOM_SWITCH) && bGo)   // keep moving the router up until we hit the calibration bar or top limit
                {
                  curPos = sRouter.currentPosition() - stepSize;
                  sRouter.move(curPos);
                  sRouter.setSpeed( -workingMotorSpeed);
                  while (sRouter.currentPosition() != sRouter.targetPosition())
                    sRouter.runSpeed();
                  btPower.getValue(&bGo);
                  //bGo = checkStopButton();
        
                }
              if (!bGo)
                bGo = turnMotorOff(UP);
            
              sRouter.setCurrentPosition(0);
              strcpy(buffer, "tUpLimit.txt=\"0.00\"");
              nexSerial.write(buffer);
              FlushBuffer();
              setPositionField(1); 
            }
          else        // we have chosen to 0 the fence.   Need to check if zeroing from the front to back, or back to front
            {
              swFenceDir.getValue (&uDirection);
              while (digitalRead(FENCE_ZERO) && digitalRead(BACK_SWITCH) && bGo && digitalRead (FRONT_SWITCH))   // keep moving the router up until we hit the calibration bar or top limit
                {             
                  if (uDirection == 0 )
                    curPos = sFence.currentPosition() - stepSize;
                  else
                    curPos = sFence.currentPosition() + stepSize;
                  sFence.move(curPos);
                  if (uDirection == 0 )
                    sFence.setSpeed ( -workingMotorSpeed);
                  else
                    sFence.setSpeed (workingMotorSpeed);
                  sFence.runSpeedToPosition();
                  //bGo = checkStopButton();
                  btPower.getValue(&bGo);
                }
              if (!bGo)
                bGo = turnMotorOff(UP);
            
              sFence.setCurrentPosition(0);
              setPositionField(0); 
            }
        }
        
/******************************************************************
   void bChangeBitPopCallback(void *ptr)

   Button bHomeChageBit component pop callback function.
   Moves the router up at max speed until the limit switch is hit

 01/03/2021 -- move the fence back to the back limit switch.   Need to move the fence out of the way of the router hole insert  
******************************************************************/
        void bChangeBitPopCallback(void *ptr) {
        
          uint32_t  speedFlag;
          char   buffer[12];
        
          bGo = DOWN;
          rMax.getValue(&speedFlag);
          if (speedFlag == 1)
          {
            highLimit = -moveRouterToLimit (DOWN, maxMotorSpeed);
          }
          else
          {
            highLimit = -moveRouterToLimit ( DOWN, -1 );
          }        
          setPositionField(1);        
        }
                        
/*****************************************************
   bToBottomPopCallback(void *ptr)

         Button bToBottom component pop callback function.
         Moves the router up at max speed until the limit switch is hit (Bottom Limit Switch)
***************************************/
        void bToBottomPopCallback(void *ptr) {
        
          uint32_t  speedFlag;
        
          bGo = DOWN;
          rMax.getValue(&speedFlag);
          if (speedFlag == 1)
          {
            lowLimit = -moveRouterToLimit (UP, maxMotorSpeed);
          }
          else
          {
            lowLimit = -moveRouterToLimit ( UP, -1 );
          }
          setPositionField(1);
        }
               
/***********************************************
   void bCalibPopCallback(void *ptr)

         Button bCalib component push callback function.
         WMoves the router to the bottom limit switch, sets the bottom limit field, then moves to top limit switch and sets upper limit field value

  01/03/2021 --- implement the logic for limits for the fence as well.   There should be an upper, lower, front and back limit for the 2 motors  
**************************/
        
        void bCalibPopCallback(void *ptr) {
        
          char    buffer[16];
          float   temp;
          double  curPosInch;
        
          //  mover router to upper limit switch, set the uppor limit variable, then move to bottom Limit switch, store bottom limit
          bGo = DOWN;
          highLimit = -moveRouterToLimit( DOWN, maxMotorSpeed );
          if (bGo)
          {
            memset (buffer, '\0', sizeof(buffer));
            temp = sRouter.currentPosition() * distPerStep / 4;
            dtostrf(-temp, 3, 4, buffer);
            tUpLimit.setText(buffer);
        
            lowLimit = -moveRouterToLimit( UP, maxMotorSpeed );
            if (bGo)
            {
              memset (buffer, '\0', sizeof(buffer));
              curPosInch = sRouter.currentPosition() * distPerStep / 4; // converts the current position to inches from 0
              dtostrf(-curPosInch, 3, 4, buffer);
              tLowLimit.setText(buffer);
            }
          }
          setPositionField(1);
        }
        
/******************************************************
   void bAutoMovePopCallback(void *ptr)

         Button bAutoMove component pop callback function.
         need to check values of direction and move switch to ensure we are moving the right direction
         if switch is set to "goto" we can only go up... it doesn't make sense to goto a negative position
         as the bit will be below the table
         
*********************************************/
        void bAutoMovePopCallback(void *ptr) {
          //  value from swHow   1 is move ||  0 is goto top of table, set bit to height
          //  value from swDirection  0 moves DOWN  || 1 moves UP
        
          float       microSteps = 0;
          uint32_t    bDirection;
          uint32_t    bHow;
          byte        finished = LOW;
          int         StructIndex;
          byte        dir;
          byte        gomove;
          float       calcInch;
          int         selection = 0;
          int         cBuff = -1;       // variable to check whether or not the stop button has been pressed
        
          swHow.getValue(&bHow);
          gomove = bHow;

     /*  CDW  01/23/2022 -- set the 2nd parameter to preSetNum instead of 0.   preSetNum is set when the     
                            cbPreSets is selected.  preSetNum should be the index of the structure to find and convert 
                            to steps, and move the motor  */

          
          StructIndex = stepsFromDistance(HIGH, preSetNum);
          if (gomove == 0 && StructIndex >= 0)
          {
            bgotoZeroPopCallback(&bgotoZero);   // if we are setting an absolute value, go to 0 first, then set the bit height (testing for Fence handled inside)
          }
           
        if (StructIndex >= 0)
          {
            microSteps = (microPerStep * 4) * preSetLookup.steps;
 
            if (HOME_MOTOR == 1)
              curPos = sRouter.currentPosition();
            else
              curPos = sFence.currentPosition();
          }
        if (microSteps)       // only move if there are steps to move, All logic should be wrapped in a mocrosteps function
          {
            if (gomove == LOW)
            {
              swDirection.setValue(LOW);
            }
            swDirection.getValue(&bDirection);
            if (bDirection == UP)
            {
              if (HOME_MOTOR )
                {
                  curPos = sRouter.currentPosition() - microSteps;
                  sRouter.move(curPos);
                  sRouter.setSpeed(-workingMotorSpeed);
                }
              else
                {
                  curPos = sFence.currentPosition() - microSteps;
                  sFence.move(curPos);
                  sFence.setSpeed(-workingMotorSpeed);
                }        
            }
            else
            {
              if (HOME_MOTOR)
                {
                  curPos = sRouter.currentPosition() + microSteps;
                  sRouter.move(curPos);
                  sRouter.setSpeed(workingMotorSpeed);
                }
              else
                {
                  curPos = sFence.currentPosition() + microSteps;
                  sFence.move(curPos);
                  sFence.setSpeed(workingMotorSpeed);
                }
              
            }
            if (HOME_MOTOR)
             {
                while (sRouter.currentPosition() != curPos  && cBuff == -1 && !digitalRead(TOP_SWITCH) && !digitalRead (BOTTOM_SWITCH))
                  {
                    sRouter.runSpeed();
                    cBuff = nexSerial.read();   // 02_12_2023 -- replaced the button read
                  }
        

                if (digitalRead(BOTTOM_SWITCH))
                  {
                    nexSerial.print("vis pStop,1");              // bring up the Stop sign to help remind we have hit a limit switch
                    FlushBuffer();
                    bounceMotorOffLimit (BOTTOM_SWITCH, UP, &sRouter);   // 11_20_2022 -- call function instead of all bouncing logic in code
                    lowLimit = -curPos;
                  }
                else if (digitalRead (TOP_SWITCH))
                  {
                    nexSerial.print("vis pStop,1");              // bring up the Stop sign to help remind we have hit a limit switch
                    FlushBuffer();
                    bounceMotorOffLimit (TOP_SWITCH, DOWN, &sRouter );   // 11_20_2022 -- call function instead of all bouncing logic in code
                    highLimit = -curPos;
                  }                 
                nexSerial.print("vis pStop,0");              // bring up the Stop sign to help remind we have hit a limit switch
                FlushBuffer();
                setPositionField(1);
              }
            else
              {
                 while (sFence.currentPosition() != curPos  && cBuff == -1 && digitalRead(FRONT_SWITCH) && digitalRead(BACK_SWITCH))
                    {
                      sFence.runSpeed();
                      cBuff = nexSerial.read();     // 02_12_2023 -- replaced the button read
                    }
        
                if (!digitalRead (BACK_SWITCH) )
                  {
                    nexSerial.print("vis pStop,1");              // bring up the Stop sign to help remind we have hit a limit switch
                    FlushBuffer();
                    bounceMotorOffLimit (BACK_SWITCH, FORWARD, &sFence);  // 11_20_2022 -- call function instead of all bouncing logic in code
                    lowLimit = -curPos;
                  }
                if (!digitalRead (FRONT_SWITCH) )
                  {
                    nexSerial.print("vis pStop,1");              // bring up the Stop sign to help remind we have hit a limit switch
                    FlushBuffer();
                    bounceMotorOffLimit (FRONT_SWITCH, BACK, &sFence);  // 11_20_2022 -- call function instead of all bouncing logic in code
                    highLimit = curPos;
                  }
      
                nexSerial.print("vis pStop,0");              // bring up the Stop sign to help remind we have hit a limit switch
                FlushBuffer();
                setPositionField(0);
              }
            
          } // end of If microsteps > 0
          setPositionField(1);
          setPositionField(0);
        }
        
/***********************************************
   void bgotoZeroPopCallback(void *ptr)

         Button bgotoZero component push callback function.
        Moves the Router or Fence to the previously set 0 position

  01/03/2021 --- implement check for fence or router movement.   Same logic can be used, but need a flag for whether we are moving the fence       
**************************/
        
        void bgotoZeroPopCallback(void *ptr) {
          String  sHold;
          long    newPos;
          char    buffer[16];
          int     test;
          uint32_t  but;

          vaDelIndex.getValue(&but);
          test = but;
          bGo = DOWN;
          vaFence.getValue (&but);   // need to test variable set by the screen navigation buttons.   When moving off th ehome screen, variable set to Router
          HOME_MOTOR = but;

          if (HOME_MOTOR == 1)
            {
               curPos = sRouter.currentPosition();
               sRouter.move(0);
            }
          else
            {
              curPos = sFence.currentPosition();
              sFence.move(0);
            }          
          if (curPos < 0)
            if (test != 100)
              if (HOME_MOTOR == 1)
                sRouter.setSpeed(workingMotorSpeed);
              else
                sFence.setSpeed (workingMotorSpeed);
            else
              if (HOME_MOTOR == 1)
                sRouter.setSpeed( maxMotorSpeed);
              else
                sFence.setSpeed (maxMotorSpeed);
          else
            if ( test != 100)
              if (HOME_MOTOR == 1)
                sRouter.setSpeed (-workingMotorSpeed);
              else
                sFence.setSpeed (-workingMotorSpeed);
            else
              if (HOME_MOTOR == 1)
                sRouter.setSpeed (-maxMotorSpeed);
              else
                sFence.setSpeed (-maxMotorSpeed);
          
          if (HOME_MOTOR == 1)
            {
              while (sRouter.currentPosition() != 0 && bGo )
                {
                  sRouter.runSpeed();
                  //btPower.getValue(&bGo);
                }
              setPositionField(1);
            }
          else
            {
              while (sFence.currentPosition() != 0 && bGo )
                {
                  sFence.runSpeed();
                  //btPower.getValue(&bGo);
                }
              setPositionField(0);
            }
          
        }
        
/***********************************************
   void bSetDownPushCallback(void *ptr)

         Button bSetDown component push callback function. (on Memory Screen)
         Moves the router down, using the same function as the button on the HOME screen
**************************/
        
        void bSetDownPushCallback(void *ptr) {
        
          bMoveDownPushCallback (&bSetDown);     //call the Callback function for the button from Home page
        }
          
/***********************************************
   void btPowerPopCallback(void *ptr)

         Button btPower component pop callback function.
         if the motor controller enablePin is off, sets it on, and vice versa.
**************************/
        
        void btPowerPopCallback(void *ptr) {
          uint32_t  butVal;
          int       temp;
      
          btPower.getValue(&butVal);
          temp = butVal;        
          if (temp == 0 )
            bGo = turnMotorOff (UP);
          else
            bGo = turnMotorOff( DOWN);
        }
        
/***********************************************
   void btSetOffPopCallback(void *ptr)

         Button btPower component push callback function.
         if the motor controller enablePin is off, sets it on, and vice versa.     
         
**************************/
        
        void btSetOffPopCallback(void *ptr) {
          uint32_t    butVal;
          int         temp;
          int         myVal;

         btSetOff.getValue(&butVal);
          temp = butVal;        
          if (temp == 0 )
          {
            bGo = turnMotorOff (UP);
          }
          else
          {
            bGo = turnMotorOff(DOWN);
          }    
        }
        
/***********************************************
   void btMemOffPopCallback(void *ptr)

         Button btPower component push callback function.
         if the motor controller enablePin is off, sets it on, and vice versa.
         
**************************/
        
        void btMemOffPopCallback(void *ptr) {
          uint32_t  butVal;
          int       temp;
        
          btMemOff.getValue(&butVal);
          temp = butVal;
        
          if (temp == 0)
          {
            bGo = turnMotorOff (UP);
          }
          else
          {
            bGo = turnMotorOff(DOWN);
          }
        }
        
/************************************************************
   void nSpdPopCallback(void *ptr)

         Number field nSpd<index> component pop callback function.
         When the field in the UI is clicked, get the field value and calculate the % of the MaxValue of the slider
         Set the value of the setSpeed field.  That value will be used later to control the speed at which the motor moves up and down
*************************************************************/
        void nSpdPopCallback(void *ptr) {
          uint32_t   scrVal;
          float     temp;
          int       spd;
        
          vaSpeed.getValue( &scrVal);

          temp = scrVal;
          if (temp == 0)
            spd = DOWN;
          else if (temp == 100)
            {
              spd = HIGH;
              temp = maxMotorSpeed;
            }
            
          else
            spd = UP;
          setSpeedFromSlider (temp, spd);
        
        }
        
/*******************************************************************
     void cbPreSetsPopCallBack(void *ptr(

           ComboBox cbPreSets component push callback function.
           A list of preset distances for the router to travel.   This will work with in conjuction with
           swHow and either move the selected amount of distance from a 0'ed spot, or set the bit to the selected
           amount from the surface of the table.   Obviously, we need to know where the surface of the table is

           Need to write serial commands directly for functions, as there are no libraries for this.   assemble the command, then FlushBuffer();
***************************************************************/
        
        void cbPreSetsPopCallBack(void *ptr) {
        
          char           buffer[15] = {'\0'};
        
          memset(buffer, '\0', sizeof(buffer));
          tHoldCombo.getText(buffer, sizeof(buffer));    // gets the text from the preset distance combo box
          memset (preSetTxt, '\0', sizeof(preSetTxt));
          strncpy(preSetTxt,buffer, sizeof(preSetTxt)-1);
          memset(buffer, '\0', sizeof(buffer));
          tHolder.getText(buffer, sizeof(buffer));      // reading the value from the Nextion variable set when the value is selected
          preSetNum = atoi(buffer);
          if (preSetNum > 0)
          {
            setPositionField(1);
          }
        }
        
/************************************************************
   void hMoveSpeedPopCallback(void *ptr)
        Slider hSlider component push callback function
        nSetSpeed is set through tht events in the Nextion IDE.  when the
        PopCallback is fired, we want to set the working motor speed, nothing else
**********************************************************/
        
        void hMoveSpeedPopCallback(void *ptr) {
          uint32_t scrVal;
          float perCalc;
          int slideVal;

          hMoveSpeed.getValue(&scrVal);
          slideVal = scrVal;    // This is the line the overwrites the memory buffer for workingMotorSpeed   conversion of a UINT32_t to a float, cannot be done this way
          setSpeedFromSlider(float(slideVal), DOWN);
        }
        
/***********************************************
    void  bSetMotorPopCallback (void *ptr)
        function to set the motor working speeds from  the settings screen in the app
        
**************************/
        
        void bSetMotorPopCallback (void *ptr) {
          char      motorMax[16] = {'\0'};
          char      workSpeed[16] = {'\0'};
          char      stepStore[8] = {'\0'};
          long      spdVal;
          long      maxMotorSpeed;
        
          memset (motorMax, '\0', sizeof(motorMax));
          memset (workSpeed, '\0', sizeof(workSpeed));
          memset (stepStore, '\0', sizeof(stepStore));
          tMaxSpeed.getText (motorMax, sizeof(motorMax));
          tWorkSpeed.getText (workSpeed, sizeof(workSpeed));
          tStepSize.getText (stepStore, sizeof(stepStore));
        
          maxMotorSpeed = atol(motorMax);
          hMoveSpeed.setMaxval(maxMotorSpeed);
          spdVal = atol(workSpeed);
          if (spdVal > maxMotorSpeed)
            spdVal = maxMotorSpeed;
          hMoveSpeed.setValue(spdVal);
          sRouter.setSpeed (spdVal);                     // set the initial router lift speed to the speed shown on the display
          sFence.setSpeed (spdVal);
          hMoveSpeedPopCallback(&hMoveSpeed);                       // if there is a value for the slider, set the variables in this program
          stepSize = atoi(stepStore);
        
        
        }
        
/***********************************************
    void  bSaveFilePopCallBack (void *ptr)
        function to set the motor working speeds from  the settings screen in the app
    
    09_20_2021 -->   Need to rewrite this section to write to the EEPROM instead of writing 
                     to the file on the SD card
    10_10_2021 -->  haven't re-written this section yet.   Have to figure out memory location and logic
**************************/
        
        void bSaveFilePopCallback (void *ptr) {
        
          char  temp[300] = {'\0'};
          char  newFile[30] = {'\0'};
          SdBaseFile   fSave, fWrite;
          unsigned long   filePos;
          int   action;
          int   numChars = 1;
          char  oldFileName[30] = {'\0'};
          char  checker;
         
          memset (newFile, '\0', sizeof(newFile));
          tFileName.getText(newFile, sizeof(newFile));
          action = ErrorDialog (210);   
          strncpy (oldFileName, storeFile, sizeof(storeFile));
          strncpy(storeFile, newFile, sizeof(storeFile));
          temp[0] = '\0';
          if ( fSave.open (fileName) && fWrite.open (fileName, FILE_WRITE))
            {
              fSave.rewind();
              memset(temp, '\0', sizeof(temp));
              while (temp[0] != char(138)  )                        // read through the header of the file, find the file name section
              {
                filePos = fSave.curPosition();
                numChars = fSave.fgets(temp, sizeof(temp));
              }
              fSave.fgets(temp, sizeof(temp));                      // read the version configuration line
              fWrite.seekSet(filePos);
          
              sprintf_P(newFile, PSTR("%c%s%c\n"), char(138), storeFile, char(138));
              fWrite.write(newFile);
              fWrite.write(temp);                                   // write version back into config file
              numChars = strlen(oldFileName) - strlen(storeFile);    // if the file name is shorter, clean out the remaining letters
              if ( numChars > 0)
              {
                for (int index = 1; index <= numChars; index++)
                {
                  fWrite.write('\0');
                }
              }
              fWrite.sync();
              fSave.close();
              fWrite.close();
            }
          else
            ErrorDialog (212 );  //212
          if (action == 5) 
            {
              //  reuse the file handles to open the old memory config file, read the comments from the top of the file
              //  write them into the new file as a header
              fSave.open(oldFileName);
              fWrite.open(storeFile, FILE_WRITE);
              checker = fSave.read();
              while (checker != '^' && fSave.available())
              {
                fWrite.write(checker);
                checker = fSave.read();
              }
              fWrite.write(checker);
              fWrite.write('\n');
              for (int index=1; index <= 7; index++)
                {
                  sprintf_P(temp, PSTR(",#,%d,,,,\n"),index);
                  fWrite.write(temp);
                }
              fWrite.sync();
              fSave.close();
              fWrite.close();     
            }
          else if (action == 4)
            if (fSave.open (storeFile))
              fSave.close();
            else
              ErrorDialog (214);  
     }
        
/***********************************************
    void bSavePopCallback (void *ptr)
        when the button is pushed on the memory screen, the Nextion will set a screen variable to the button number
        all buttons will call the same PopCallback, and we will get the button number from the variable   
**************************/
        
        void bSavePopCallback (void *ptr) {

          int  index;
          uint32_t save;

          vaIndex.getValue(&save);
          index = save;
          saveToMemory(index);
        }
/***********************************************
    void bDeletePopCallback (void *ptr)
    when the button is pushed on the memory screen, the Nextion will set a screen variable to the button number
        all buttons will call the same PopCallback, and we will get the button number from the variable   
*********************************************/
        
        void bDeletePopCallback (void *ptr) {
          int  index;
          uint32_t save;

          vaDelIndex.getValue(&save);
          index = save;
          deleteFromMemory(index);
        }
/***********************************************
   void btoFilePopCallback (void *ptr)
      function to write values to the SD card.
      when the button is pressed, we set a variable in the Nextion.  That index will tell which button is pressed, 
      and we will construct the object names to pass to the memToFileSD function
**************************/
      
        void btoFilePopCallback (void *ptr) {
          int  index;
          uint32_t save;
          
          vaSDIndex.getValue(&save);
          index = save;

          switch (index)
            {
              case 1:
                memToFileSD ( index, tMem1, tZero1, tMem1Steps, ',', '#');
                break;
              case 2:
                memToFileSD ( index, tMem2, tZero2, tMem2Steps, ',', '#');
                break;
              case 3:
                memToFileSD ( index, tMem3, tZero3, tMem3Steps, ',', '#');
                break;
              case 4:
                memToFileSD ( index, tMem4, tZero4, tMem4Steps, ',', '#');
                break;
              case 5:
                memToFileSD ( index, tMem5, tZero5, tMem5Steps, ',', '#');
                break;
              case 6:
                memToFileSD ( index, tMem6, tZero6, tMem6Steps, ',', '#');
                break;
              case 7:
                memToFileSD ( index, tMem7, tZero7, tMem7Steps, ',', '#');
                break;
            }
        }

   /***********************************************
    void bLoadPopCallback (void *ptr)
        When the button is pressed, a variable is set in the NExtion.   This fuction will retrieve the variable
        and construct the object name to send to loadMemorytoRouter function
**************************/
              
        void bLoadPopCallback (void *ptr)  {
          int  index;
          uint32_t save;
          char  steps[17];

          vaIndex.getValue(&save);
          index = save;
          switch (index)
            {
              case 1:
                loadMemorytoRouter(tZero1, HIGH);
                break;
              case 2:
                loadMemorytoRouter( tZero2, HIGH);
                break;
              case 3:
                loadMemorytoRouter( tZero3, HIGH);
                break;
              case 4:
                loadMemorytoRouter( tZero4, HIGH);
                break;
              case 5:
                loadMemorytoRouter(tZero5, HIGH);
                break;
              case 6:
                loadMemorytoRouter( tZero6, HIGH);
                break;
              case 7:
                loadMemorytoRouter( tZero7,HIGH);
                break;
            }
          }

/*********************************************************
     void  bLoadMemPopCallback (void *ptr)
            Triggers the loading of data from a storage file to the memory screen fields
            will call a function called LoadFromFile()

            169 is the copyright symbol.  Is the token to separate the values in the stream
            216  is the section indicator to show the Memory screen
 *******************************************************/
        void  bLoadMemPopCallback (void *ptr)  {
        
          int  numWritten;
        
          //   numWritten = LoadFromFile(1, 7, 169, 216);
          numWritten = LoadFromFile(1, 7, ',', '#');
        }
/**************************************************
      void bSDCardPopCallback (void *ptr)
         function to restart the SD card controller.   Reissuing the SDCard Begin, resets the card reader after removing SDCard
 ***************************************************/

        void bSDCardPopCallback( void *ptr) {
        
          if (!sdCard.begin(SD_WRITE))
          {
            ErrorDialog (101 );
          }
        
        }

/************************************************
 * void mCustomBitPopCallback (void *ptr)
 *         function to set the heights for the custom bit configurations
 ************************************************/
        void mCustomBitPopCallback (void *ptr)   {

            int  index;
            uint32_t  save;
            char   sCommand[120];
            char   inches[9];

            nBit.getValue(&save);
            index = save;
            stepsFromDistance (LOW, index);
            if (preSetLookup.decimal != 0)
              {
                sprintf_P(sCommand, PSTR("t2.txt=\"%s\""),preSetLookup.label);
                nexSerial.write(sCommand);
                FlushBuffer(); 
                dtostrf(preSetLookup.decimal, 3, 4, inches);       
                t3.setText (inches);
                FlushBuffer();
              }
            else
              {
                sprintf_P(sCommand, PSTR("t2.txt=\"ERROR\""));
                nexSerial.write(sCommand);
                FlushBuffer(); 

              }              
        }
        
/******************************************************************************
   SETUP the main pieces of the program
        
        void setup(void) {
        
          /* You might need to change NexConfig.h file in your ITEADLIB_Arduino_Nextion folder
            Set the baudrate which is for debug and communicate with Nextion screen
            nexInit() = sets the Nextion to Seriel3, and sets baud rate to 9600 unless a value is passed to nexInit()
        
                 01/23/2020  CDW ==>    Modified NexConfig.h, and set the nexSerial to Seriel3.   When implemneting, don't know the exact wriring
                                        config I will use, but in the nexInit prototype , the value for nexSerial needs to be set to the appropriate
                                        port AND!!!!!! the ground from the connector to the nextion must be connected to the ground from the board.  If not,
                                        the listener does not hook up, the Nextion listener  does not function properly, and there is no event queue in
                                        the arduino.
*******************************************************************************/
       void setup (void) 
         {
         
            float perCalc;
            float slideVal;
            uint32_t  scrVal;
            SdBaseFile   fPins;
            int   numChars;
            
            char          pinsString[40] = {'\0'};
       /*     char          motorString[40] = {'\0'};
            char          memFile[30] = {'\0'};
            char          delim[2] = {char(222), '\0'};
            char          delimCheck = char(222);
            char          *token;
            int           index;
            char          checker;*/
            
            nexInit(115200);     //  with enahanced libraries, can pass a baud rate to the Nextion (115200 set on preinitialize of Home)
            //nexBAUD(250000);

            Serial.begin(1000000);
            // Register the pop event callback function of the components
            
            btPower.attachPop(btPowerPopCallback, &btPower);                    //  turn the motor controller on and off by setting the enablePin
            btSetOff.attachPop(btSetOffPopCallback, &btSetOff);                  //  turn the motor controller on and off by setting the enablePin
            btMemOff.attachPop(btMemOffPopCallback, &btMemOff);                  //  turn the motor controller on and off by setting the enablePin     
            bCalib.attachPop(bCalibPopCallback, &bCalib);                       //  Button to move lift to top limit, set top, bottom limit set bottom       
    /*************  home screen 4 buttons Push*/         
            bMoveUp.attachPush(bMoveUpPushCallback, &bMoveUp);                  //  Move Up push - Home Screen
            bForward.attachPush(bForwardPushCallback, &bForward);               //  Move Fence to bit, push - home screen
            bBack.attachPush(bBackPushCallback,&bBack);                         //  Move Fence away from bit, push -- home screen
            bMoveDown.attachPush(bMoveDownPushCallback, &bMoveDown);            //  Move Down press - Home Screen

            /*********** home screen 4 buttons POP ****/
            bForward.attachPop(bForwardPopCallback, &bForward);                 //  Move fence to bit release - home screen
            bBack.attachPop(bBackPopCallback, &bBack);                          //  Move Fence away from bit, release -- home screen
            bMoveDown.attachPop(bMoveDownPopCallback, &bMoveDown);              //  Move Down release - Home Screen
            bMoveUp.attachPop(bMoveUpPopCallback, &bMoveUp);                    //  Move Up release - Home Screen      
    /*********** Settings screen 4 buttons PUSH****/         
            bUp.attachPush(bMoveUpPushCallback, &bUp);                          //  Move Up push - Settings Screen
            bDown.attachPush(bMoveDownPushCallback, &bDown);                    //  Move Down press - Settings Screen         
            bSetBack.attachPush(bBackPushCallback, &bSetBack);                    //  Move Back push - Settings Screen         
            bSetForward.attachPush(bForwardPushCallback, &bSetForward);          //  Move Forward press  (Settings)     
    /************ Settings Screen 4 buttons POP ******/        
            bSetForward.attachPop(bForwardPopCallback, &bSetForward);           //  Move Forward release - Settings Screen
            bSetBack.attachPop(bBackPopCallback, &bSetBack);                   //  Move Back release - Settings Screen
            bDown.attachPop (bMoveDownPopCallback, &bDown);
            bUp.attachPop (bMoveUpPopCallback, &bUp);
    /************Memory Screen   4 buttons Push ******/         
            bMemForward.attachPush(bForwardPushCallback, &bMemForward);         //  Move Forward press  (Memory Memory)                        
            bSetUp.attachPush(bMoveUpPushCallback, &bSetUp);                    //  Move Up push  (Memory Screen)
            bMemBack.attachPush(bBackPushCallback, &bMemBack);                  //  Move Up push  (Memory Screen)          
            bSetDown.attachPush(bMoveDownPushCallback, &bSetDown);              //  Move Down press  (Memory Screen)
    /**********Memory Screen 4 buttons POP ******/
            bMemForward.attachPop(bForwardPopCallback, &bMemForward);         //  Move Forward release  (Memory Memory)                        
            bSetUp.attachPop(bMoveUpPopCallback, &bSetUp);                    //  Move Up release  (Memory Screen)
            bMemBack.attachPop(bBackPopCallback, &bMemBack);                  //  Move Up release  (Memory Screen)          
            bSetDown.attachPop(bMoveDownPopCallback, &bSetDown);              //  Move Down release  (Memory Screen)                                

            swHow.attachPop(swHowPopCallback, &swHow);                          //  handling the auto move   1 = MOVE selected amount, 0 = move to that absolute position (up only)
            bReZero.attachPop(bReZeroPopCallback, &bReZero);                    //  ReZero release
            bZero.attachPop(bZeroPopCallback, &bZero);                          //  Zero button on the Settings Page
            bChangeBit.attachPop(bChangeBitPopCallback, &bChangeBit);           //  Change bit on the home page
            bToBottom.attachPop(bToBottomPopCallback, &bToBottom);              //  Bottom out router - check where the bottom limit switch is
            bAutoMove.attachPop(bAutoMovePopCallback, &bAutoMove);              //  "GO!" button to move the distance off the preset drop down
            bgotoZero.attachPop(bgotoZeroPopCallback, &bgotoZero);              //  moves to the 0 setting, up if below, and down if above
            bBottomOut.attachPop(bToBottomPopCallback, &bBottomOut);           //  Bottom out router (Settings) - check where the bottom limit switch is
            bLiftBit.attachPop(bChangeBitPopCallback, &bLiftBit);                 //  Change bit on the Settings page
            nSpd0.attachPop(nSpdPopCallback, &nSpd0);                           //   0 on the scale next to the slider.   will set motor to 0% of MAXSPEED
            nSpd2.attachPop(nSpdPopCallback, &nSpd2);                           //  20 on the scale next to the slider.   will set motor to 20% of MAXSPEED
            nSpd4.attachPop(nSpdPopCallback, &nSpd4);                           //  40 on the scale next to the slider.   will set motor to 40% of MAXSPEED
            nSpd6.attachPop(nSpdPopCallback, &nSpd6);                           //  60 on the scale next to the slider.   will set motor to 60% of MAXSPEED
            nSpd8.attachPop(nSpdPopCallback, &nSpd8);                           //  80 on the scale next to the slider.   will set motor to 80% of MAXSPEED
            nSpd10.attachPop(nSpdPopCallback, &nSpd10);                         //  100 on the scale next to the slider.   will set motor to 100% of MAXSPEED
//            bSetPins.attachPop(bSetPinsPopCallback, &bSetPins);                 //  set the new pins for the connections for overall digital configuration
            bSetMotor.attachPop(bSetMotorPopCallback, &bSetMotor);              //  Set the speeds and step variables for the motor
            bSaveFile.attachPop(bSaveFilePopCallback, &bSaveFile);              //  resets the momory save file name, and writes new file name to pinsconfig.cfg
            bMemZero.attachPop(bgotoZeroPopCallback, &bMemZero);                //  calls the home screen gotoZero event handler.  drops the router to the 0 position
            swFence.attachPop(swFencePopCallback, &swFence);                    //  Home screen switch for which motor to handle zero and resetting
            swWhich.attachPop(swWhichPopCallback, &swWhich);                    //  Settings screen switch for which motor is used to handle calibration
            cbPreSets.attachPop(cbPreSetsPopCallBack, &cbPreSets);
            
            hMoveSpeed.attachPop(hMoveSpeedPopCallback, &hMoveSpeed);
            
            /****************************************************
                 setting up the memory screen.   not going to document every call back, as they all do the sam
            ***********************************/
            
            bLoad1.attachPop ( bLoadPopCallback, &bLoad1);
            bLoad2.attachPop ( bLoadPopCallback, &bLoad2);
            bLoad3.attachPop ( bLoadPopCallback, &bLoad3);
            bLoad4.attachPop ( bLoadPopCallback, &bLoad4);
            bLoad5.attachPop ( bLoadPopCallback, &bLoad5);
            bLoad6.attachPop ( bLoadPopCallback, &bLoad6);
            bLoad7.attachPop ( bLoadPopCallback, &bLoad7);
            
            bSave1.attachPop ( bSavePopCallback, &bSave1);
            bSave2.attachPop ( bSavePopCallback, &bSave2);
            bSave3.attachPop ( bSavePopCallback, &bSave3);
            bSave4.attachPop ( bSavePopCallback, &bSave4);
            bSave5.attachPop ( bSavePopCallback, &bSave5);
            bSave6.attachPop ( bSavePopCallback, &bSave6);
            bSave7.attachPop ( bSavePopCallback, &bSave7);
            
            btoFile1.attachPop ( btoFilePopCallback, &btoFile1);
            btoFile2.attachPop ( btoFilePopCallback, &btoFile2);
            btoFile3.attachPop ( btoFilePopCallback, &btoFile3);
            btoFile4.attachPop ( btoFilePopCallback, &btoFile4);
            btoFile5.attachPop ( btoFilePopCallback, &btoFile5);
            btoFile6.attachPop ( btoFilePopCallback, &btoFile6);
            btoFile7.attachPop ( btoFilePopCallback, &btoFile7);
            
            bDelete1.attachPop (bDeletePopCallback, &bDelete1);
            bDelete2.attachPop (bDeletePopCallback, &bDelete2);
            bDelete3.attachPop (bDeletePopCallback, &bDelete3);
            bDelete4.attachPop (bDeletePopCallback, &bDelete4);
            bDelete5.attachPop (bDeletePopCallback, &bDelete5);
            bDelete6.attachPop (bDeletePopCallback, &bDelete6);
            bDelete7.attachPop (bDeletePopCallback, &bDelete7);
            bLoadMem.attachPop (bLoadMemPopCallback, &bLoadMem);
            bSDCard.attachPop (bSDCardPopCallback, &bSDCard);
            m0.attachPop (mCustomBitPopCallback, &m0);
            m2.attachPop (mCustomBitPopCallback, &m2);
            m3.attachPop (mCustomBitPopCallback, &m3);
            m4.attachPop (mCustomBitPopCallback, &m4);
            m5.attachPop (mCustomBitPopCallback, &m5);
            bBitsZero.attachPop (bgotoZeroPopCallback, &bBitsZero);
            bBitsLoad.attachPush (bCustBitPushCallback, &bBitsLoad);
            
           pinMode(SD_WRITE, OUTPUT);
            
            
          if (!sdCard.begin(SD_WRITE))
                ErrorDialog (101);  

            readSettingsEEPROM();         // read the config from EEPROM 

            pinMode(TOP_SWITCH, INPUT_PULLUP);          // Pin where the stop switch is wired PULLUP will define https://www.arduino.cc/en/Tutorial/InputPullupSerial
            pinMode(BOTTOM_SWITCH, INPUT_PULLUP);
            pinMode(REZERO, INPUT_PULLUP);
            pinMode(enablePin, OUTPUT);
            pinMode(stepPin, OUTPUT);
            pinMode(directionPin, OUTPUT);
            pinMode(fenceDirPin, OUTPUT);
            pinMode(fenceEnablePin, OUTPUT);
            pinMode(fenceStepPin, OUTPUT);
            pinMode(BACK_SWITCH, INPUT_PULLUP);
            pinMode(FRONT_SWITCH, INPUT_PULLUP);
            pinMode(FENCE_ZERO, INPUT_PULLUP);
                
         //   }
            //   set max speed and accelleration of the stepper motor
            
            sRouter.setMaxSpeed(maxMotorSpeed);
            sRouter.setAcceleration(maxAcceleration);
            sRouter.setMinPulseWidth(pulseWidthMicros);
            sFence.setMaxSpeed(maxMotorSpeed);
            sFence.setAcceleration(maxAcceleration);
            sFence.setMinPulseWidth(pulseWidthMicros);
    
            bGo = turnMotorOff( DOWN);                           // turns Router motor controller on, gives the torque necessary to hold the router in place
            getSettingsScreen(pinsString);
            scrVal = maxMotorSpeed;
            hMoveSpeed.setMaxval(scrVal);
            sRouter.setSpeed (workingMotorSpeed);                     // set the initial router lift speed to the speed shown on the display
            sFence.setSpeed (workingMotorSpeed);
            cbPreSetsPopCallBack(&cbPreSets);                         // if there is a value in the presets, we need to initialize the preSets variables
            hMoveSpeedPopCallback(&hMoveSpeed);                       // if there is a value for the slider, set the variables in this program    
            
  // 03_10_2023 -- CDW added the checks for the router or fence being pegged on startup

            if (digitalRead(TOP_SWITCH) || digitalRead (BOTTOM_SWITCH))
              if (digitalRead(TOP_SWITCH))
                bounceMotorOffLimit (TOP_SWITCH, DOWN, &sRouter );    
              else
                bounceMotorOffLimit (BOTTOM_SWITCH, UP, &sRouter ); 
            if (digitalRead (BACK_SWITCH) || digitalRead (FRONT_SWITCH))
              if (digitalRead(BACK_SWITCH))
                bounceMotorOffLimit (BACK_SWITCH, FORWARD, &sFence);   
              else
                bounceMotorOffLimit (FRONT_SWITCH, BACK, &sFence);   
              
              

            setPositionField(1);
            setPositionField(0);
            Home.show();
        }
/**********************************************        
 *     void  loop (void)
 *          main loop of the program
 ***********************************************/
        void loop(void) {
          
            nexLoop(nex_listen_list);

        }
