cwiegert/RouterLift-v5.6-EEPROM/(commit log)

2021-10-11 cleaning up directory -cleaning up memory storage
    [Error.cfg, LiftConfig.cfg, LiftPinsConfig _ Baseline for starting project.txt, LiftPinsConfig.cfg]
2022-01-02 Updated UI to eliminate resetting eEPROM from UI.
    [EEPROM_Writer_Router.ino, RouterEEPROMGlobals.h, RouterLiftNextionObjects.h, Wiegert_Lift_v560_09_20_2021.ino]
2022-06-13 updated bugs fro the set position and SaveToMemory on 2/22/2022
    because of adding the fence automation, there were errors in the SaveToMemory function
    [RouterLiftGlobVars.h, Wiegert_Lift_v560_09_20_2021.ino]
2022-08-29 modified custom bits section to fix EEPROM read bug
    In the stepsFromDistance function, There was a EEPROM.read function to pull the custom bits heights, where it should have been EEPROM.get. Because the address was written into EEPROM with a put, a read would not pull back binary. Updated and fixed bug of the height of the bit was not being added to the bit travel on automated centering of the custom bits
    [RouterEEPROMGlobals.h, RouterLiftGlobVars.h, Wiegert_Lift_v560_09_20_2021.ino]
2022-11-21 version 11_20_2022
    modified the bouncing off the limit switches using a function (bounceOffLimitSwitch) and fixed a number of small bugs with direction. Code refactoring to be consistent with functions in other automation tools.
    [EEPROM_Writer_Router.ino, RouterEEPROMGlobals.h, RouterLiftGlobVars.h, Wiegert_Lift_v560_09_20_2021.ino]
2022-12-08 modified loadtoRouter to account for change to limit switches
2022-12-12 cleared compiling warnings and fixed bounce
    cleaning up code to remove compiler warnings. Changed bounceOffLimit function to make sure the conditions will test to TRUE as appropriate
    [RouterLiftGlobVars.h, Wiegert_Lift_v560_09_20_2021.ino]
2022-12-13 reverted checkStopButton
    put the while loop back in. the previous modification, while logically made sense, didn't catch all the button pushing from teh stop buttons
    [Wiegert_Lift_v560_09_20_2021.ino]
2023-02-15 Update Wiegert_Lift_v560_09_20_2021.ino
    removed the check stop buton in the automove, will read nexSerial instead. reading the button value in the move loop was too slow and too much overhead
    [Wiegert_Lift_v560_09_20_2021.ino]
2026-09-20 Vendor Nextion library, fix compile errors, cut RAM usage 73% -> 54%
    Build fixes (sketch would not compile as-is):
    - RouterLiftGlobVars.h: include <Nextion.h>; FlushBuffer() uses nexSerial
    but the header was included before anything declared it.
    - RouterLiftNextionObjects.h: drop dangling &bSetPins from the touch event
    list; its declaration was removed but the array entry remained.
    - Fix BOTOM_SWITCH -> BOTTOM_SWITCH typo in the startup limit check.
    - Fix misplaced paren in the startup limit check: digitalRead(TOP_SWITCH ||
    digitalRead(BOTTOM_SWITCH)) collapsed to reading pin 0 or 1 instead of the
    limit switches. NOTE: this activates startup limit-bounce logic that has
    never effect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
    [RouterLiftGlobVars.h, RouterLiftNextionObjects.h, Wiegert_Lift_v560_09_20_2021.ino]
2026-09-20 Add 2026 Nextion HMI design alongside the 2021 one
    Sourced from the Synology copy of this project, unchanged. Kept beside
    Wiegert_Lift_v560_09_20_2021.HMI rather than replacing it.
    The HMI is the Nextion Editor source; the panel is flashed from a .tft
    built from it, via the display's own SD card (not the Arduino).
